rudikershaw/water-alarm/(commit log)

2018-12-17 Add more placeholder text into the main README.md in case anyone is looking.
2018-12-17 Add web service for relaying information between the hardware and mobile app.
2018-12-17 Add schematic to hardware README.md
2018-12-21 Update hardware README.md to include basic assembly
2018-12-21 Add clarification on schematic to hardware README.md
2020-02-11 #1 Switch .ino to rest call for pushover notifications.
2020-02-16 #1 Fix .ino file so that it succesfully contacts the pushover API.
    [water-alarm.ino]
